zaberwolfi/ESP32-S3-Smart-Golf-Trolley/3D_Modelle_PETG/Tasterplatine_Schablone.pdf

# Schablone Tasterplatine Fernsteuerung (1:1)

Stand 25.10.2026 · Lochraster 34 × 48 mm · passend zur vorhandenen Oberschale

### Ansicht von OBEN (Tastenseite)

Loch Ø2,4 | Loch | Ø2,4

Vor

Zurück

Links | Rechts

Stop

Schalter

LED (über der Platine)

34 mm

48 mm

unten = Stop-Seite (Bandöse)

### Ansicht von UNTEN (Lötseite)

Loch Ø2,4 | Loch | Ø2,4

Vor

Zurück

Rechts | Links

Stop

Schalter

LED (über der Platine)

34 mm

48 mm

unten = Stop-Seite (Bandöse)

Prüflineal: muss genau 100 mm lang sein. Drucken mit „Tatsächliche Größe / 100 %“, NICHT „An Seite anpassen“.

Zeichen

- Grünes Quadrat = Tasterkörper 6 × 6 mm, gestrichelt = mit Lötbeinchen (ca. 8,6 mm).
- Rotes Kreuz = Tastermitte. Sie muss genau stimmen (±0,3 mm), sonst klemmen die Tastenkappen.
- Kreis mit Kreuz = Schraubloch Ø2,4 mm (die M2-Schraube geht durch die Platine).
- Äußerer Kreis = Schraubdom Ø5,4 mm – dort keine Bauteile und keine Drähte.
- Orange = Schiebeschalter am rechten Rand, Hebel zeigt nach außen in den Schlitz der Oberschale.
- Graues Raster = 2,54 mm. Nicht alle Tastermitten liegen auf dem Raster – maßgeblich ist das rote Kreuz.
- Unter der Platine höchstens 2 mm Bauhöhe (Drähte flach führen), darunter liegt der XIAO.

Verdrahtung (XIAO ESP32C3)

Je ein Tasterbein an GND (gemeinsame Masseleitung), das andere an den XIAO:
Vor → D1 | Zurück → D2 | Links → D3 | Rechts → D4 | Stop → D5
LED: D10 → LED (langes Bein) → kurzes Bein → 2,2 kΩ → GND
Schalter: Akku rot → Schalter → BAT+ (Unterseite XIAO); Akku schwarz → BAT−

Anwendung

1. Seite 1:1 drucken und das Prüflineal nachmessen.
2. „Ansicht von OBEN“ ausschneiden, mit wenig Klebestift auf die Tastenseite der Platine kleben.
3. Schraublöcher und Tastermitten mit einer Nadel anstechen, Platine am Umriss zuschneiden.
4. Papier abziehen, Schraublöcher auf 2,4 mm aufbohren, Taster nach den Markierungen setzen.
