zaberwolfi/ESP32-S3-Smart-Golf-Trolley/3D_Modelle_PETG/Frontplatte_Schilder.stl

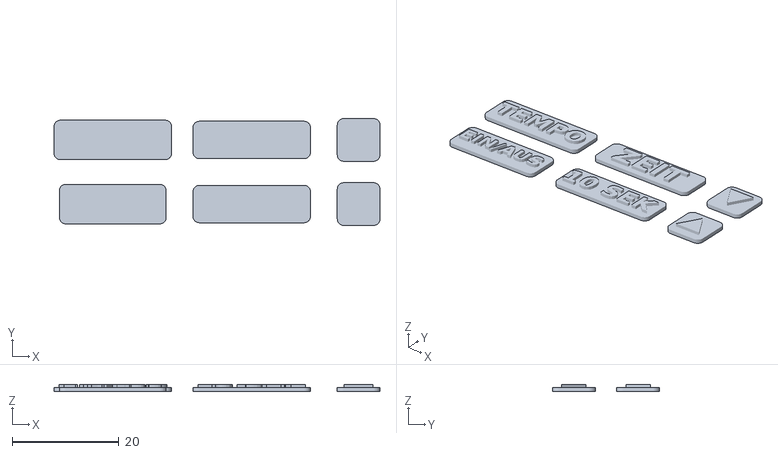
[picture p1: CAD file, 2026-10-26]
3D_Modelle_PETG/Frontplatte_Schilder.stl
61.0 x 20.0 x 1.40
