zaberwolfi/ESP32-S3-Smart-Golf-Trolley/3D_Modelle_PETG/Fernsteuerung_Kappen_Pfeile.stl

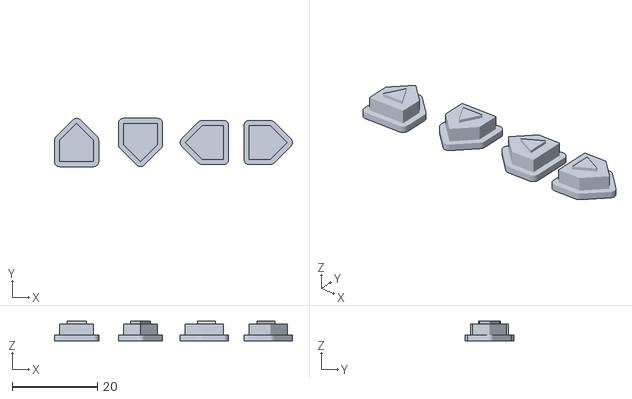
[picture p2: CAD file, 2026-10-26]
3D_Modelle_PETG/Fernsteuerung_Kappen_Pfeile.stl
55.9 x 11.4 x 4.59
