zaberwolfi/ESP32-S3-Smart-Golf-Trolley/3D_Modelle_PETG/Fernsteuerung_Kappe_Stop.stl

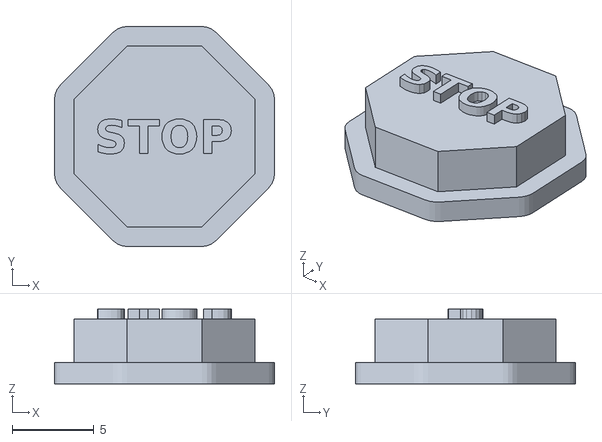
[picture p4: CAD file, 2026-10-26]
3D_Modelle_PETG/Fernsteuerung_Kappe_Stop.stl
13.5 x 13.5 x 4.59
