zaberwolfi/ESP32-S3-Smart-Golf-Trolley/3D_Modelle_PETG/Fernsteuerung_Oberschale.stl

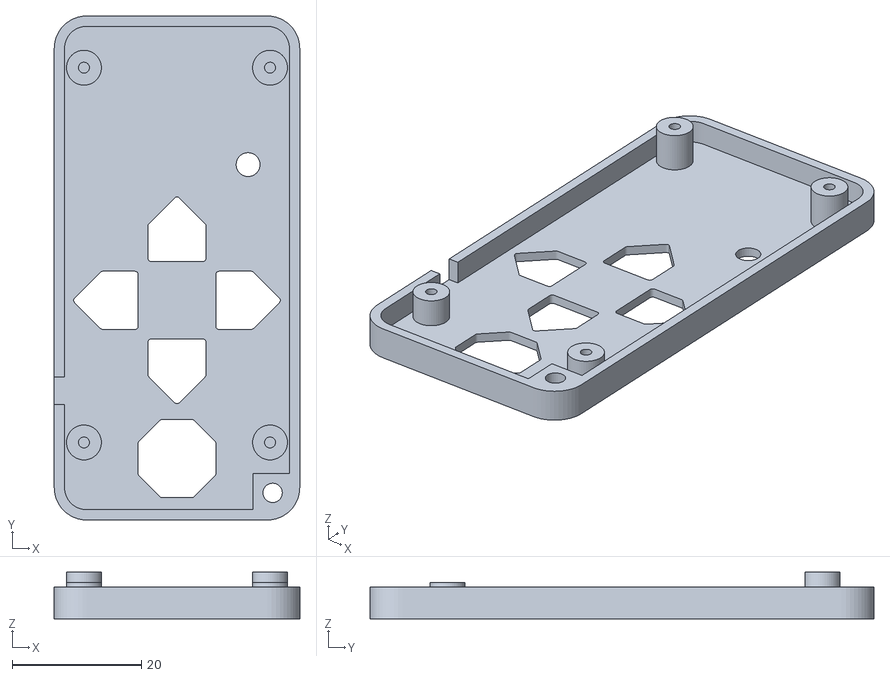
[picture p5: CAD file, 2026-10-26]
3D_Modelle_PETG/Fernsteuerung_Oberschale.stl
38.0 x 78.0 x 7.20
