zaberwolfi/ESP32-S3-Smart-Golf-Trolley/3D_Modelle_PETG/Frontplatte_Bedienteil_Test.stl

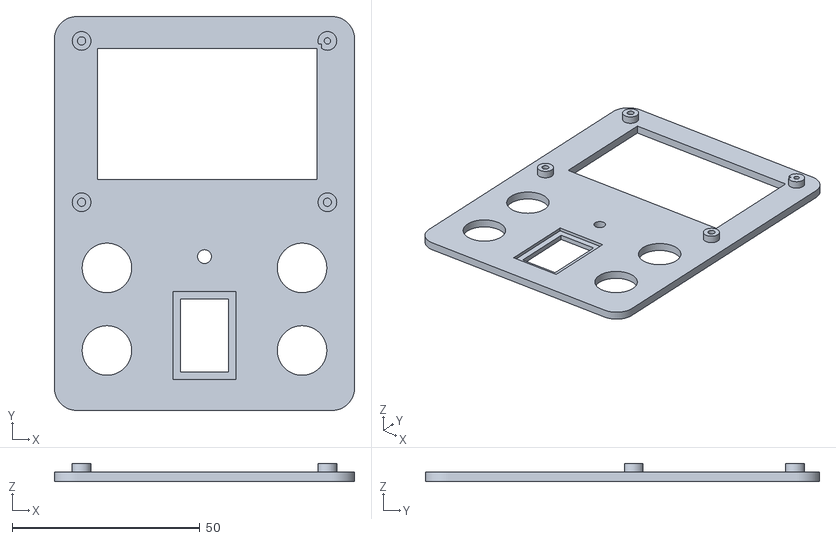
[picture p6: CAD file, 2026-10-26]
3D_Modelle_PETG/Frontplatte_Bedienteil_Test.stl
80.0 x 105.0 x 4.80
